gsusdev/YASLI/README.md

# YASLI
Yet another smart light implementation
