gsusdev/YASLI/hw/doc/Перечень_2021-02-14.xlsx

 |  |  |  |  |  |  |  |  | Комплектов | 3 |  |  |  | Чип и Дип |  |  |  | Электронщик |  |  |  | Китай
BomGroup | BomTitle | Designator | Type | Value | Case | Voltage | Dielectric | Quantity | % | Всего | Есть | Купить | Место | Цена | Ст. 1 | Выбор | Ст. 2 | Цена | Ст. 1 | Выбор | Ст. 2 | Цена | Ст. 1 | Выбор | Ст. 2
Диоды | Диод Шоттки | VD9 | SS14 |  | SMA |  |  | 1 | 0.1 | 3 | 10 | -7 | Коробка «YASLI» | 6 | 6 |  | 0 | 2.7 | 2.7 | 1 | 2.7 |  | 0 |  | 0
Диоды | Диод Шоттки | VD1.1, VD1.2, VD1.3, VD1.4, VD1.5, VD1.6, VD1.7, VD1.8, VD1.9, VD1.10, VD1.11, VD1.12, VD1.13, VD1.14, VD1.15, VD1.16, VD3, VD4, VD5 | BAT54WS |  | SOD-323 |  |  | 19 | 0.8 | 57 | 82 | -25 | Коробка «YASLI» | 2 | 38 |  | 0 | 1.3 | 24.7 | 1 | 24.7 |  | 0 |  | 0
Диоды | Симистор | VS1.1, VS1.2, VS1.3, VS1.4, VS1.5, VS1.6, VS1.7, VS1.8 | BTA16-600CRG |  | TO-220FP |  |  | 8 | 9.4 | 24 | 4 | 20 | Коробка «YASLI», Заказ ДКО | 55 | 440 |  | 0 | 39 | 312 |  | 0 |  | 0 |  | 0
Диоды | Стабилитрон | VD11 | BZX84C10 |  | SOT-23-3 | 10 В |  | 1 | 0.0 | 3 | 8 | -5 | Коробка «YASLI» |  | 0 |  | 0 |  | 0 |  | 0 |  | 0 |  | 0
Диоды | Супрессор | VD10 | SMBJ15CA-TR |  | SMB |  |  | 1 | 0.2 | 3 | 8 | -5 | Коробка «YASLI» | 10 | 10 |  | 0 | 4.8 | 4.8 | 1 | 4.8 |  | 0 |  | 0
Индуктивности | Дроссель подавления ЭМП | L2 | BLM21AG601SN1D |  | 0805 |  |  | 1 | 0.0 | 3 | 8 | -5 | Коробка «YASLI» |  | 0 |  | 0 |  | 0 |  | 0 |  | 0 |  | 0
Индуктивности | Индуктивность SMD | L1 | SDR0604-100ML | 10 мкГн | SDR0604 |  |  | 1 | 0.8 | 3 | 7 | -4 | Коробка «YASLI» | 36 | 36 |  | 0 | 13 | 13 | 1 | 13 |  | 0 |  | 0
Конденсаторы | Конденсатор керамический SMD | C21 | GRM21BR71E104KA01L | 0.1 мкФ | 0805 | 25 В | X7R | 1 | 0.0 | 3 | 4 | -1 | Коробка «YASLI» |  | 0 |  | 0 |  | 0 |  | 0 |  | 0 |  | 0
Конденсаторы | Конденсатор керамический SMD | C2, C4, C6, C8, C11, C13, C14, C15, C18, C19, C24, C25, C27, C29, C30, C31, C37, C38 | GRM188R71H104K | 0.1 мкФ | 0603 | 50 В | X7R | 18 | 0.0 | 54 | 72 | -18 | Пакет 1 |  | 0 |  | 0 |  | 0 |  | 0 |  | 0 |  | 0
Конденсаторы | Конденсатор керамический SMD | C9.1, C9.2, C9.3, C9.4, C9.5, C9.6, C9.7, C9.8, C9.9, C9.10, C9.11, C9.12, C9.13, C9.14, C9.15, C9.16 | GRM43DR72J104K | 0.1 мкФ | 1812 | 630 В | X7R | 16 | 4.1 | 48 | 32 | 16 | Коробка «YASLI» | 12 | 192 |  | 0 | 6.4 | 102.4 | 1 | 102.4 |  | 0 |  | 0
Конденсаторы | Конденсатор керамический SMD | C17 | GRM188R60J106ME47D | 10 мкФ | 0603 | 6.3 В | X5R | 1 | 0.0 | 3 | 16 | -13 | Коробка «YASLI» |  | 0 |  | 0 |  | 0 |  | 0 |  | 0 |  | 0
Конденсаторы | Конденсатор керамический SMD | C20 | GRM31CR71E106KA12L | 10 мкФ | 1206 | 25 В | X5R | 1 | 0.3 | 3 | 8 | -5 | Коробка «YASLI» | 13 | 13 |  | 0 | 4.3 | 4.3 | 1 | 4.3 |  | 0 |  | 0
Конденсаторы | Конденсатор керамический SMD | C1, C3 | GRM1885C1H120J | 12 пФ | 0603 | 50 В | NP0 | 2 | 0.0 | 6 | 8 | -2 | Едут из ДКО |  | 0 |  | 0 |  | 0 |  | 0 |  | 0 |  | 0
Конденсаторы | Конденсатор керамический SMD | C26 | GRM188R61A225K | 2.2 мкФ | 0603 | 10 В | X5R | 1 | 0.0 | 3 | 5 | -2 | Коробка «YASLI» |  | 0 |  | 0 |  | 0 |  | 0 |  | 0 |  | 0
Конденсаторы | Конденсатор керамический SMD | C22 | GRM31CR61C226ME15L | 22 мкФ | 1206 | 16 В | X5R | 1 | 0.6 | 3 | 8 | -5 | Коробка «YASLI» | 30 | 30 |  | 0 | 6.4 | 6.4 | 1 | 6.4 |  | 0 |  | 0
Конденсаторы | Конденсатор керамический SMD | C5, C10, C12, C28, C32 | GRM21BR60J226M | 22 мкФ | 0805 | 6.3 В | X5R | 5 | 1.4 | 15 | 35 | -20 | Коробка «YASLI» | 13 | 65 |  | 0 | 1.6 | 8 | 1 | 8 |  | 0 |  | 0
Конденсаторы | Конденсатор металлоплёночный | C23.1, C23.2, C23.3, C23.4, C23.5, C23.6, C23.7, C23.8 | К73-17 | 0.1 мкФ |  | 630 В |  | 8 | 4.5 | 24 | 16 | 8 | Не нужно | 26 | 208 |  | 0 | 18.6 | 148.8 | 1 | 148.8 |  | 0 |  | 0
Микросхемы | Микросхема | VD2 | SP0503BAHTG |  |  |  |  | 1 | 1.2 | 3 | 5 | -2 | Коробка «YASLI» | 58 | 58 |  | 0 | 17 | 17 | 1 | 17 |  | 0 |  | 0
Микросхемы | Микросхема | G1 | TPS560200DBV |  | SOT23-5 |  |  | 1 | 0.0 | 3 | 9 | -6 | Коробка «YASLI» |  | 0 |  | 0 |  | 0 |  | 0 |  | 0 |  | 0
Микросхемы | Микросхема | VD12 | SP4045-04ATG |  |  |  |  | 1 | 1.4 | 3 | 5 | -2 | Коробка «YASLI» | 66 | 66 |  | 0 | 22 | 22 | 1 | 22 |  | 0 |  | 0
Микросхемы | Микросхема | D1 | LAN8710A-EZK |  |  |  |  | 1 | 2.4 | 3 | 5 | -2 | Коробка «YASLI» | 110 | 110 |  | 0 | 63 | 63 | 1 | 63 |  | 0 |  | 0
Микросхемы | Микросхема | VD6, VD7, VD8, VD13, VD14 | SP3003-02JTG |  | SC70-5 |  |  | 5 | 2.8 | 15 | 29 | -14 | Коробка «YASLI» | 26 | 130 |  | 0 | 7.5 | 37.5 | 1 | 37.5 |  | 0 |  | 0
Микросхемы | Микросхема | DD4 | CP2102-GMR |  |  |  |  | 1 | 3.0 | 3 | 2 | 1 | YASLI+Едут с Али | 140 | 140 |  | 0 | 102 | 102 | 1 | 102 |  | 0 |  | 0
Микросхемы | Микросхема | A1 | ESP32-WROOM-32U |  |  |  |  | 1 | 8.4 | 3 | 3 | 0 | Едут с Али | 390 | 390 |  | 0 | 337 | 337 | 1 | 337 |  | 0 |  | 0
Микросхемы | Микросхема | DD1, DD2, DD3 | PCF8574TS/3 |  |  |  |  | 3 | 10.7 | 9 | 12 | -3 | Коробка «YASLI» | 167 | 501 |  | 0 | 144 | 432 |  | 0 |  | 0 |  | 0
Оптоэлектронные приборы | Оптопара транзисторная | U1.1, U1.2, U1.3, U1.4, U1.5, U1.6, U1.7, U1.8, U1.9, U1.10, U1.11, U1.12, U1.13, U1.14, U1.15, U1.16 | TLP181GB |  | 2.54SOP-4 |  |  | 16 | 17.8 | 48 | 16 | 32 | Коробка «YASLI» + Едут с Али | 52 | 832 |  | 0 | 57 | 912 |  | 0 |  | 0 |  | 0
Оптоэлектронные приборы | Оптосимистор | U2.1, U2.2, U2.3, U2.4, U2.5, U2.6, U2.7, U2.8 | MOC3063S |  | SMD-6 |  |  | 8 | 5.1 | 24 | 5 | 19 | Коробка «YASLI», Заказ ДКО | 30 | 240 |  | 0 | 20.6 | 164.8 | 1 | 164.8 |  | 0 |  | 0
Прочее | Кварцевый резонатор | ZQ1 |  | 32768 Гц |  |  |  | 1 | 0.3 | 3 | 4 | -1 | Коробка «YASLI» | 15 | 15 |  | 0 |  | 0 | 1 | 0 |  | 0 |  | 0
Прочее | Корпус на DIN-рейку |  | D9MG |  |  |  |  | 1 | 11.8 | 3 | 2 | 1 | Один корпус без пластины | 550 | 550 |  | 0 | 388 | 388 | 1 | 388 |  | 0 |  | 0
Прочее | Плата |  |  |  |  |  |  | 1 | 0.0 | 3 | 4 | -1 | Коробка «YASLI» |  |  |  |  |  |  |  |  |  | 0 |  | 0
Резисторы | Резистор SMD | R12.1, R12.2, R12.3, R12.4, R12.5, R12.6, R12.7, R12.8, R12.9, R12.10, R12.11, R12.12, R12.13, R12.14, R12.15, R12.16, R25, R37 |  | 0 Ом | 0603 |  |  | 18 | 0.8 | 54 | 50 | 4 | Коробка «YASLI» | 2 | 36 |  | 0 | 0.08 | 1.44 | 1 | 1.44 |  | 0 |  | 0
Резисторы | Резистор SMD | R7, R8 |  | 1.5 кОм | 0603 |  |  | 2 | 0.0 | 6 | 10 | -4 | Коробка «YASLI» |  | 0 |  | 0 |  | 0 |  | 0 |  | 0 |  | 0
Резисторы | Резистор SMD | R1, R2, R3, R4, R6, R10.1, R10.2, R10.3, R10.4, R10.5, R10.6, R10.7, R10.8, R10.9, R10.10, R10.11, R10.12, R10.13, R10.14, R10.15, R10.16, R15, R17, R18, R26, R44, R46 |  | 10 кОм | 0603 |  |  | 27 | 0.0 | 81 | 100 | -19 | Коробка «YASLI» |  | 0 |  | 0 | 0.1 | 2.7 | 1 | 2.7 |  | 0 |  | 0
Резисторы | Резистор SMD | R20 |  | 100 кОм | 0603 |  |  | 1 | 0.0 | 3 | 4 | -1 | Коробка «YASLI» |  | 0 |  | 0 |  | 0 |  | 0 |  | 0 |  | 0
Резисторы | Резистор SMD | R5, R14 |  | 100 Ом | 0603 |  |  | 2 | 0.0 | 6 | 4 | 2 | Коробка «YASLI» |  | 0 |  | 0 |  | 0 |  | 0 |  | 0 |  | 0
Резисторы | Резистор SMD | R23.1, R23.2, R23.3, R23.4, R23.5, R23.6, R23.7, R23.8, R24.1, R24.2, R24.3, R24.4, R24.5, R24.6, R24.7, R24.8 |  | 110 Ом | 2512 |  |  | 16 | 0.0 | 48 | 46 | 2 | Коробка «YASLI» |  | 0 |  | 0 |  | 0 | 1 | 0 |  | 0 |  | 0
Резисторы | Резистор SMD | R39 |  | 12.1 кОм | 0603 |  |  | 1 | 0.0 | 3 | 49 | -46 | Коробка «YASLI» |  | 0 |  | 0 | 0.1 | 0.1 | 1 | 0.1 |  | 0 |  | 0
Резисторы | Резистор SMD | R22.1, R22.2, R22.3, R22.4, R22.5, R22.6, R22.7, R22.8 |  | 180 Ом | 0603 |  |  | 8 | 0.0 | 24 | 42 | -18 | Коробка «YASLI» |  | 0 |  | 0 | 0.13 | 1.04 | 1 | 1.04 |  | 0 |  | 0
Резисторы | Резистор SMD | R27, R28, R29, R30, R31, R32, R41, R42, R43 |  | 2.2 кОм | 0603 |  |  | 9 | 0.0 | 27 | 18 | 9 | Коробка «YASLI» |  | 0 |  | 0 |  | 0 |  | 0 |  | 0 |  | 0
Резисторы | Резистор SMD | R38, R40 |  | 330 Ом | 0603 |  |  | 2 | 0.0 | 6 | 10 | -4 | Коробка «YASLI»
Резисторы | Резистор SMD | R21 | CRCW060320K0FKEA | 20 кОм | 0603 |  |  | 1 | 0.0 | 3 | 5 | -2 | Коробка «YASLI» |  | 0 |  | 0 |  | 0 |  | 0 |  | 0 |  | 0
Резисторы | Резистор SMD | R13 |  | 22.1 кОм | 0603 |  |  | 1 | 0.0 | 3 | 9 | -6 | Едут из ДКО |  | 0 |  | 0 |  | 0 |  | 0 |  | 0 |  | 0
Резисторы | Резистор SMD | R48.1, R48.2, R48.3, R48.4, R48.5, R48.6, R48.7, R48.8, R48.9, R48.10, R48.11, R48.12, R48.13, R48.14, R48.15, R48.16 |  | 220 кОм | 2512 |  |  | 16 | 0.0 | 48 |  | 48 | Заказ ДКО |  | 0 |  | 0 | 1.7 | 27.2 | 1 | 27.2 |  | 0 |  | 0
Резисторы | Резистор SMD | R45 |  | 33 Ом | 0603 |  |  | 1 | 0.0 | 3 | 18 | -15 | Коробка «YASLI» |  | 0 |  | 0 |  | 0 |  | 0 |  | 0 |  | 0
Резисторы | Резистор SMD | R9.1, R9.2, R9.3, R9.4, R9.5, R9.6, R9.7, R9.8, R9.9, R9.10, R9.11, R9.12, R9.13, R9.14, R9.15, R9.16, R11.1, R11.2, R11.3, R11.4, R11.5, R11.6, R11.7, R11.8, R11.9, R11.10, R11.11, R11.12, R11.13, R11.14, R11.15, R11.16 |  | 220 Ом | 2512 |  |  | 32 | 1.8 | 96 | 218 | -122 | Коробка «YASLI» | 2.6 | 83.2 |  | 0 | 1.1 | 35.2 | 1 | 35.2 |  | 0 |  | 0
Резисторы | Резистор SMD | R16 |  | 47.5 кОм | 0603 |  |  | 1 | 0.0 | 3 | 9 | -6 | Едут из ДКО |  | 0 |  | 0 |  | 0 |  | 0 |  | 0 |  | 0
Резисторы | Резистор SMD | R33, R34, R35, R36 |  | 49.9 Ом | 0603 |  |  | 4 | 0.0 | 12 | 46 | -34 | Коробка «YASLI» |  | 0 |  | 0 | 0.1 | 0.4 | 1 | 0.4 |  | 0 |  | 0
Резисторы | Резистор SMD | R19 | CRCW060362K0FK | 62 кОм | 0603 |  |  | 1 | 0.0 | 3 | 18 | -15 | Коробка «YASLI» |  | 0 |  | 0 |  | 0 |  | 0 |  | 0 |  | 0
Соединители | Клеммник винтовой |  | EK508V-03P |  |  |  |  | 6 | 6.0 | 18 | + | #VALUE! | Коробка «YASLI» | 46.67 | 280.02 |  | 0 | 13.4 | 80.4 | 1 | 80.4 |  | 0 |  | 0
Соединители | Клеммник винтовой |  | EK508V-02P |  |  |  |  | 8 | 0.0 | 24 | + | #VALUE! | Коробка «YASLI» |  | 0 |  | 0 |  | 0 | 1 | 0 |  | 0 |  | 0
Соединители | Разъём питания | XS3 | DC005 5,5*2,1 мм |  |  |  |  | 1 | 0.5 | 3 | 20 | -17 | Едут с Али | 24 | 24 |  | 0 | 10 | 10 | 1 | 10 |  | 0 |  | 0
Соединители | Розетка RJ-45 с трансформатором | XS1 | HR911105A |  |  |  |  | 1 | 2.8 | 3 | 1 | 2 | Коробка «YASLI» + Едут с Али | 130 | 130 |  | 0 | 79.5 | 79.5 | 1 | 79.5 |  | 0 |  | 0
Соединители | Соединитель штыревой | XP6 | CWF-5 |  |  |  |  | 1 | 0.0 | 3 |  | 3 | Не нужно |  | 0 |  | 0 |  | 0 |  | 0 |  | 0 |  | 0
Соединители | Соединитель штыревой | XP5 | PLD-20 |  |  |  |  | 1 | 0.3 | 3 | 4 | -1 | Коробка «YASLI» | 14 | 14 |  | 0 | 4.8 | 4.8 | 1 | 4.8 |  | 0 |  | 0
Соединители | Соединитель USB | XS2 | USB/M-1J |  |  |  |  | 1 | 0.0 | 3 | 5 | -2 | Замена, Едут с Али |  | 0 |  | 0 |  | 0 |  | 0 |  | 0 |  | 0
Транзисторы | Транзистор биполярный | VT1, VT2 | BC847A |  | SOT23-3 |  |  | 2 | 0.1 | 6 | 20 | -14 | Коробка «YASLI» | 3 | 6 |  | 0 | 0.63 | 1.26 | 1 | 1.26 |  | 0 |  | 0
Транзисторы | Транзистор N-канальный | VT5 | BSS123 |  | SOT-23-3 |  |  | 1 | 0.1 | 3 | 18 | -15 | Коробка «YASLI» | 6 | 6 |  | 0 | 1.7 | 1.7 | 1 | 1.7 |  | 0 |  | 0
Транзисторы | Транзистор P-канальный | VT3, VT4 | IRLML9303TRPBF |  | SOT-23-3 |  |  | 2 | 0.4 | 6 | 6 | 0 | Коробка «YASLI» | 10 | 20 |  | 0 | - | #VALUE! |  | 0 |  | 0 |  | 0
 |  |  |  |  |  |  |  |  |  |  |  |  |  |  | 4669.22 |  | 0 |  |  |  | 1692.14 |  |  |  | 0 | 1692.14
 |  |  |  |  |  |  |  |  |  |  |  |  |  |  |  |  | 2977.08
