gsusdev/YASLI/hw/doc/LightController_SimpleCombo.pdf

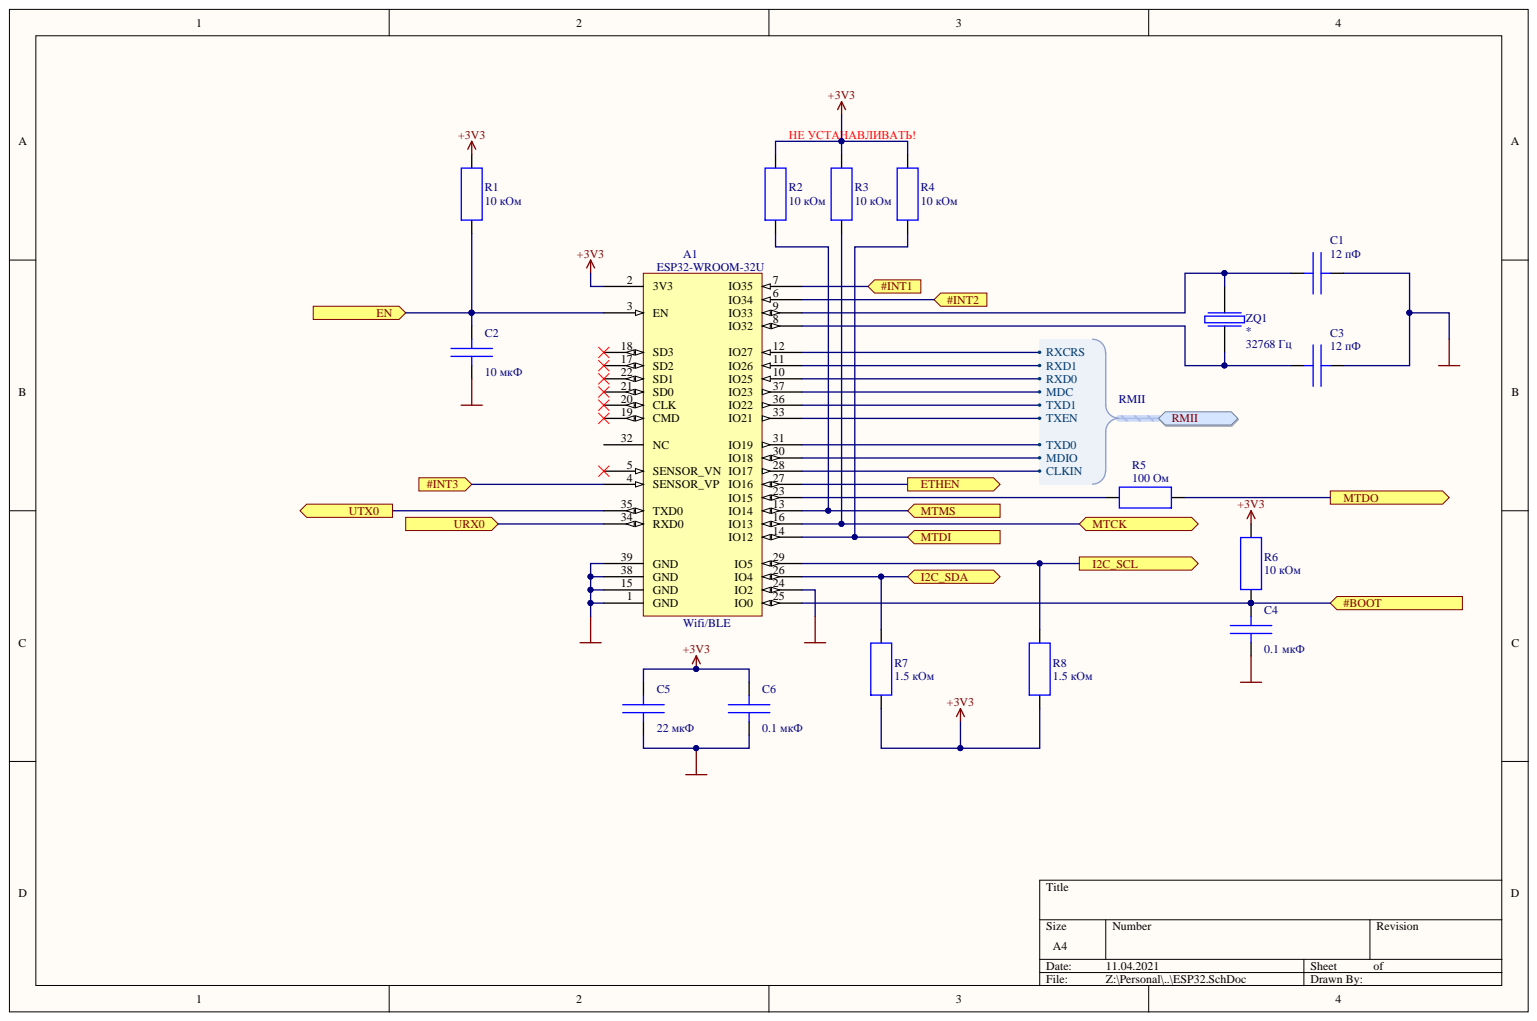
[picture p1: page 1]

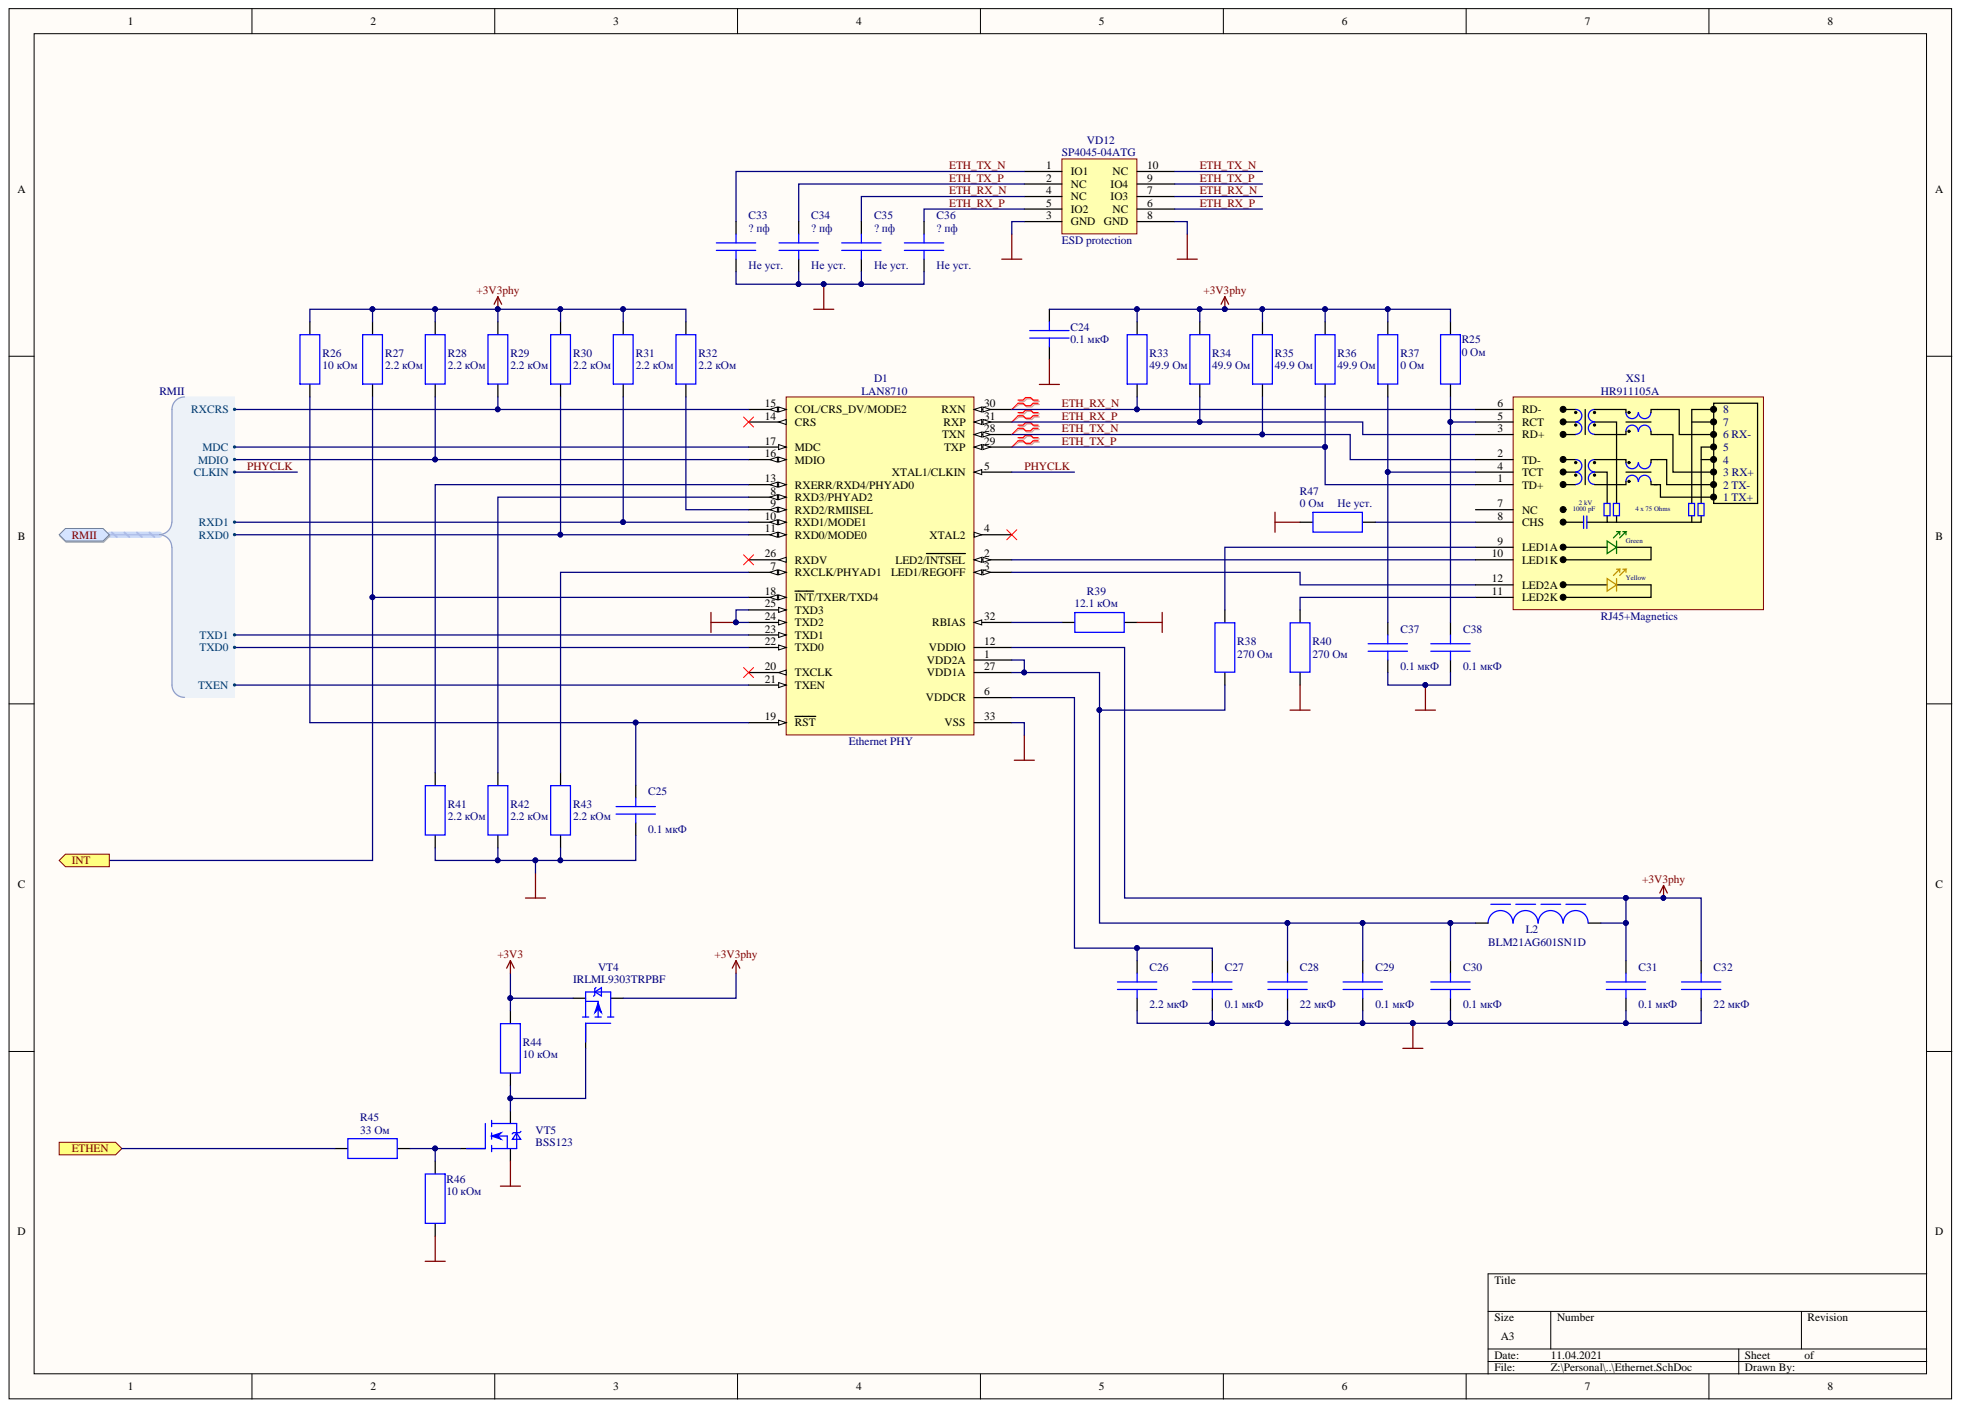
[picture p2: page 2]

ETH_TX_P | NC 2
ETH_RX_N | NC 4
ETH_RX_P
C36 | GND 3

TCT 4
TD+ 1

RXD3/PHYAD2 8 | R47 0 Ом Не уст. | NC 7
RXD2/RMIISEL 9

LED1A 9

RXCLK/PHYAD1 7 | | LED2K 11 LED2A 12

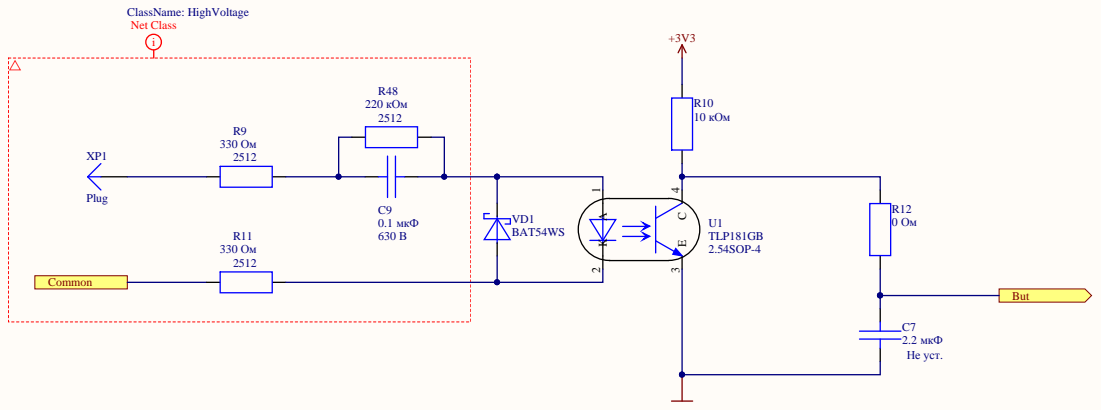
[picture p3: page 3]

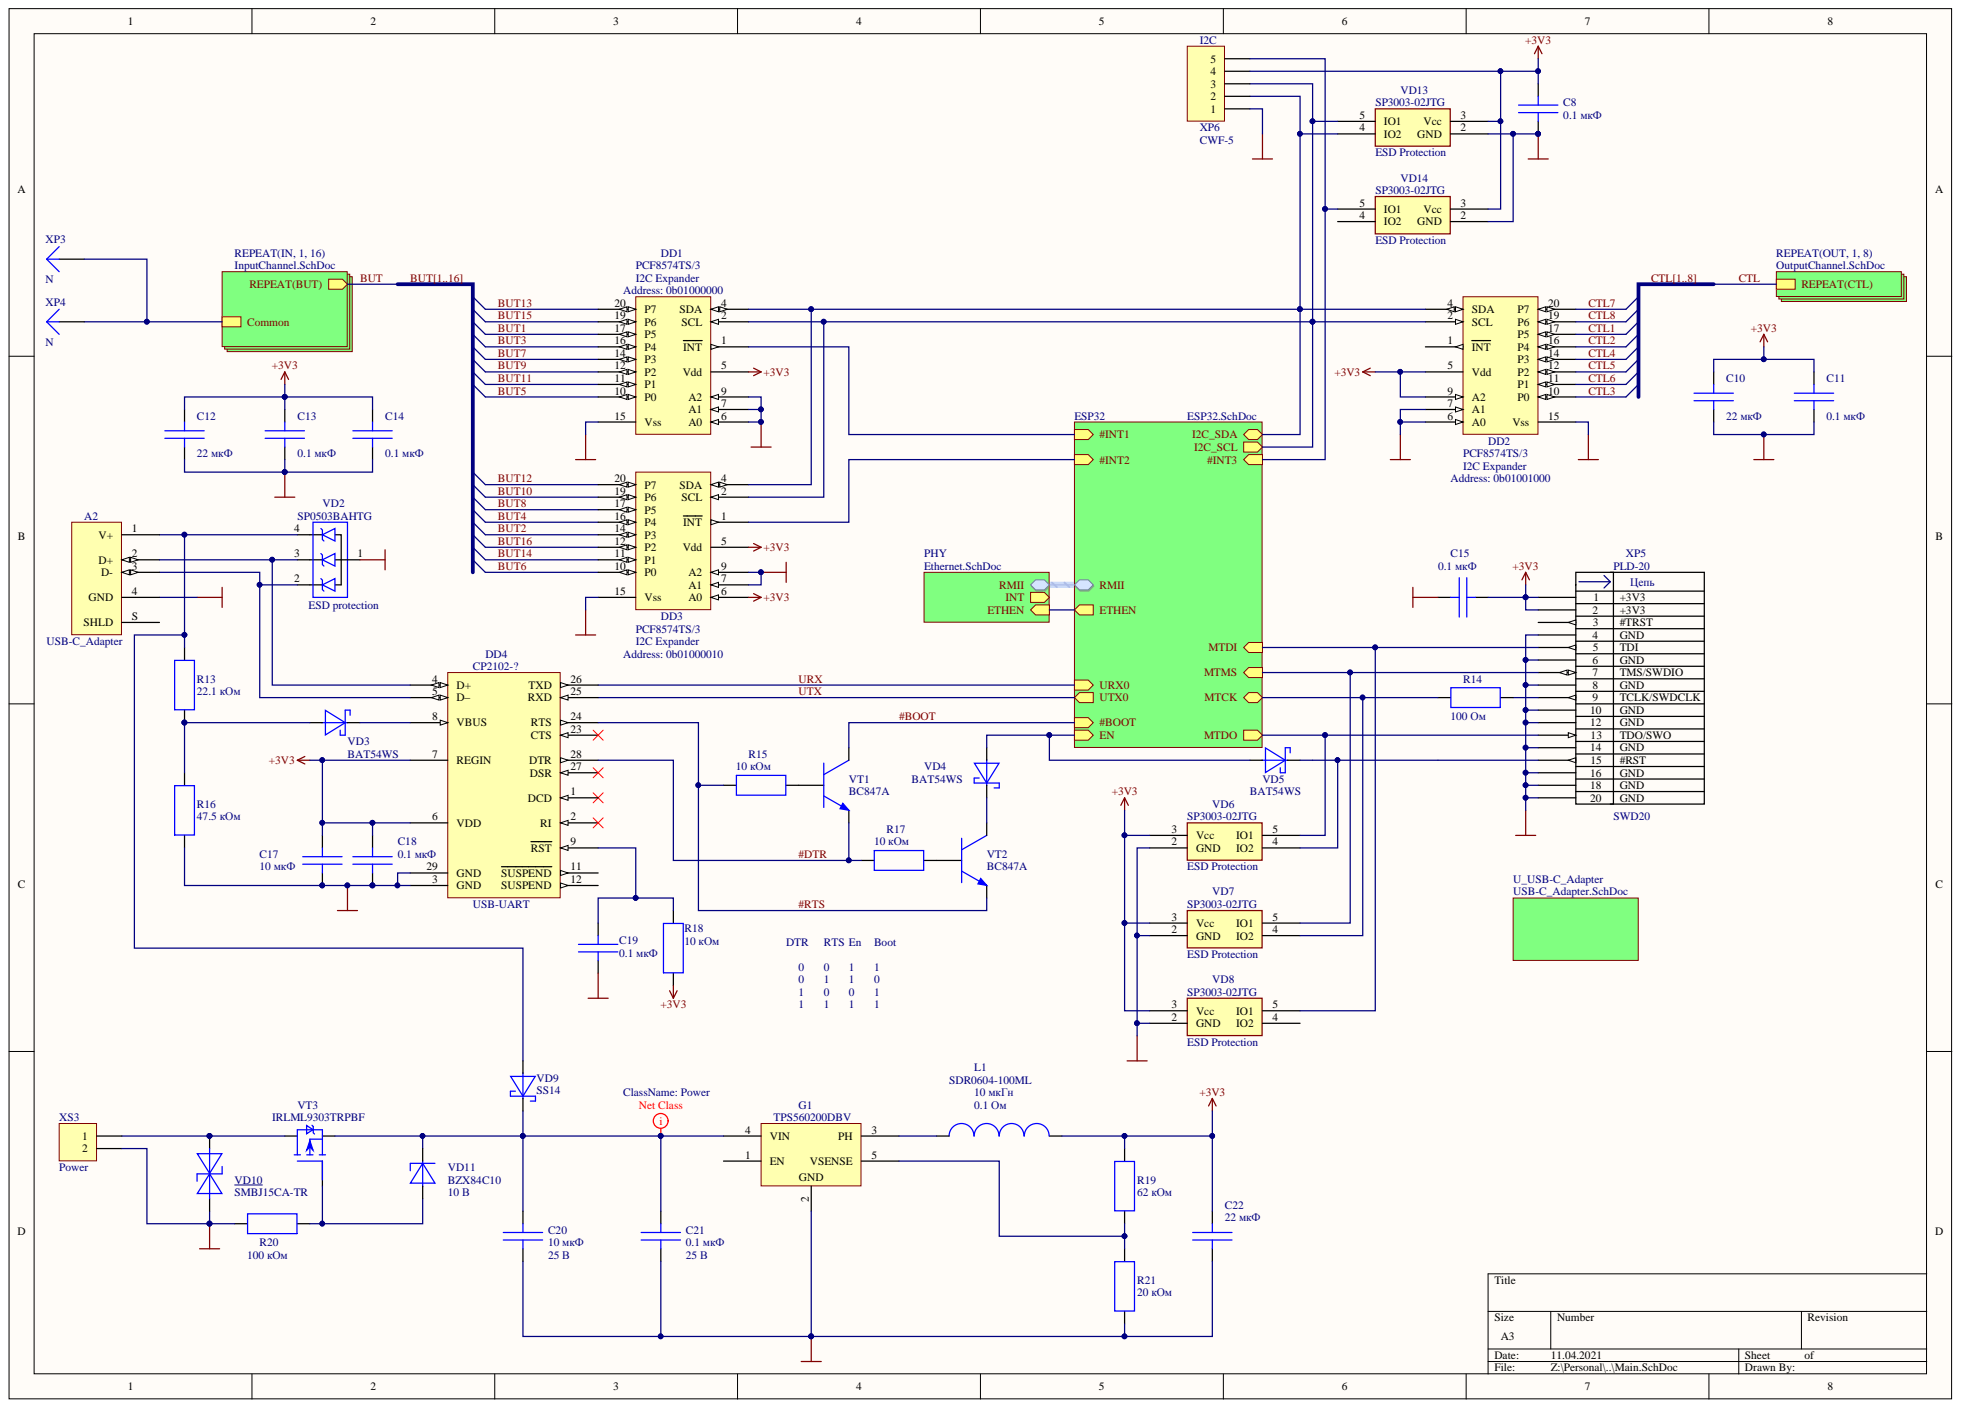
[picture p4: page 4]

2 | +3V3
3 | #TRST
4 | GND
5 | TDI
6 | GND
7 | TMS/SWDIO

22.1 кОм | D– 5 | UTX

12 | GND

+3V3 | VD3 BAT54WS | REGIN 7

14 | GND
15 | #RST

R17 | 18 | GND

20 | GND

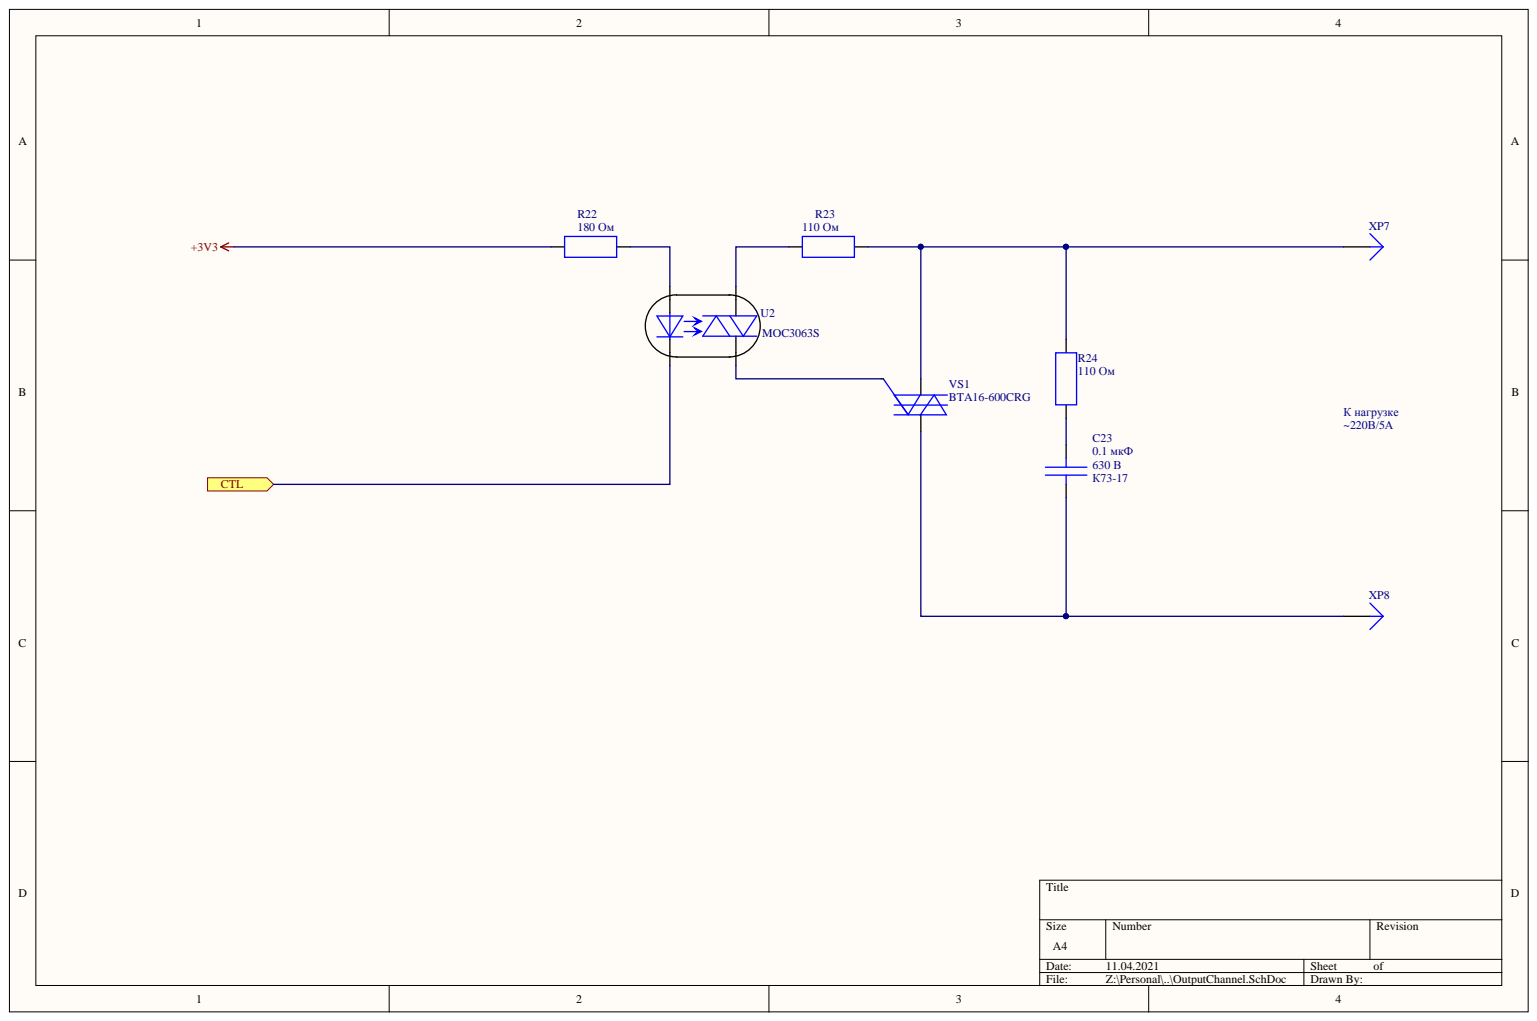
[picture p5: page 5]

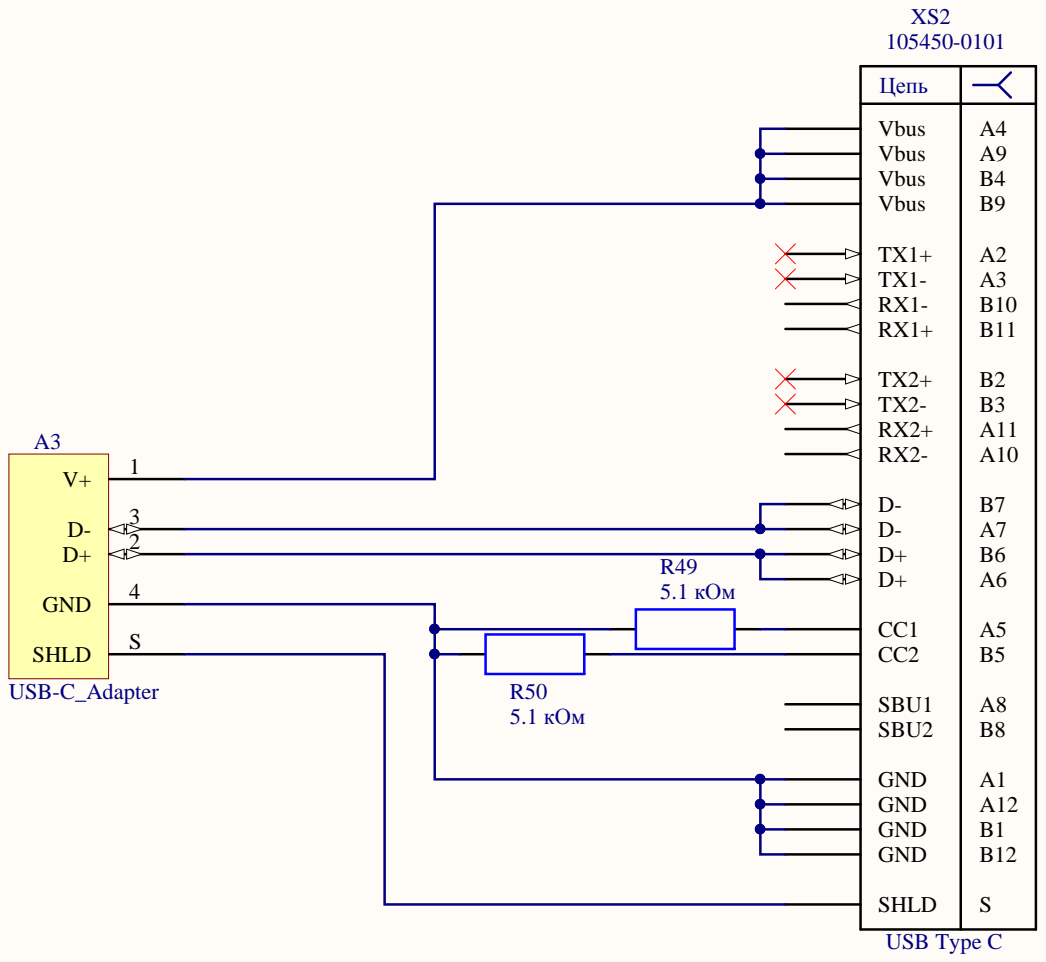
[picture p6: page 6]
