gsusdev/YASLI/(list of files, drawings)

Other design files:
hw/src/CustomFootprints.PcbLib
hw/src/CustomSymbols.SchLib
hw/src/ESP32.SchDoc
hw/src/Ethernet.SchDoc
hw/src/InputChannel.SchDoc
hw/src/LightController_SimpleCombo.PrjPCB
hw/src/Main.SchDoc
hw/src/OutputChannel.SchDoc
hw/src/USB-C_Adapter.SchDoc
hw/src/Usb_Adapter.PcbDoc
